bot43/KiCad/README.md

# KiCad
KiCad Design Files for CMPE 310 lab 5
