bot43/KiCad/parts/LCD4x20.step

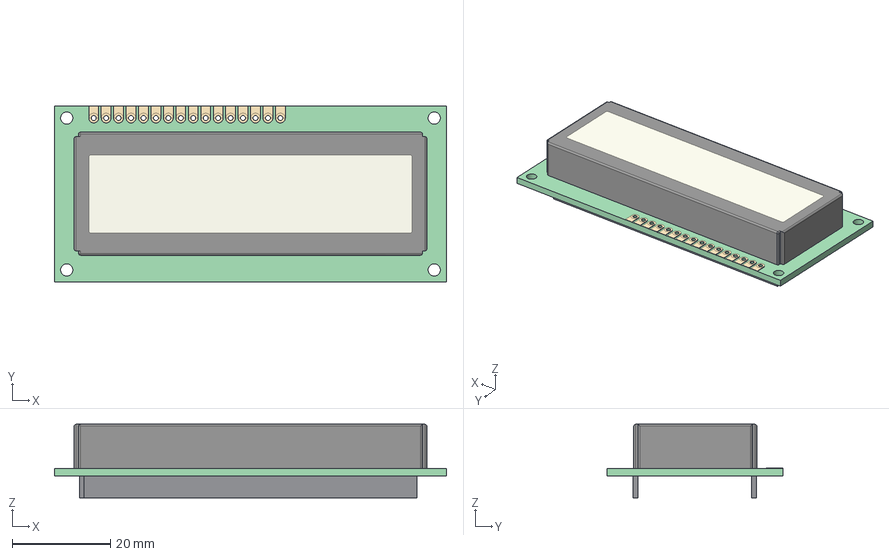
[picture p51: CAD file, 2021-04-13]
parts/LCD4x20.step
80.0 x 36.0 x 15.0 mm
