bot43/KiCad/(list of files, drawings)

Other design files:
Final.dsn
Final_take2.dsn
FinalPCB.dsn
