bot43/KiCad/(commit log)

2021-04-13 Added KiCad FIles with one resistor
    [Lab 5.kicad_pcb, Lab 5.sch]
2021-04-13 parts file
    [LCD4x20.step]
